Cimos/mad_lib/README.md

# mad_lib
kicad library for footprints, symbols, models, and schematics
