Cimos/mad_lib/part_library/models/MadMan/CrumbCatcherLight.step

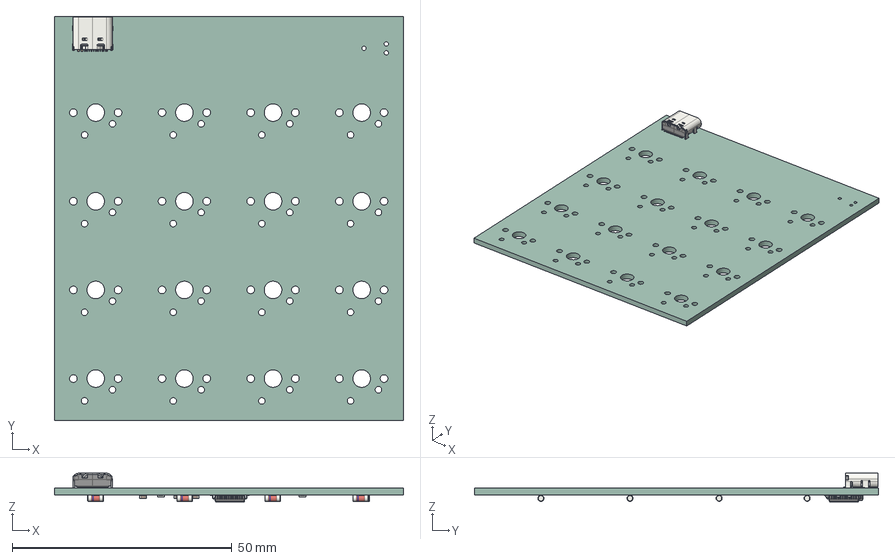
[picture p1: CAD file, 2024-03-19]
part_library/models/MadMan/CrumbCatcherLight.step
79.4 x 91.8 x 6.51 mm
USB_C_Receptacle_16P_TopMnt_Horizontal_GCT_USB4105-xx-A
R_0603_1608Metric x 6
D_MiniMELF_Standard x 16
C_0603_1608Metric x 7
LQFP_48_7x7mm_P05mm
SOT_23
CrumbCatcherLight_PCB
