Cimos/mad_lib/part_library/models/minspaced-choc-keycap.step

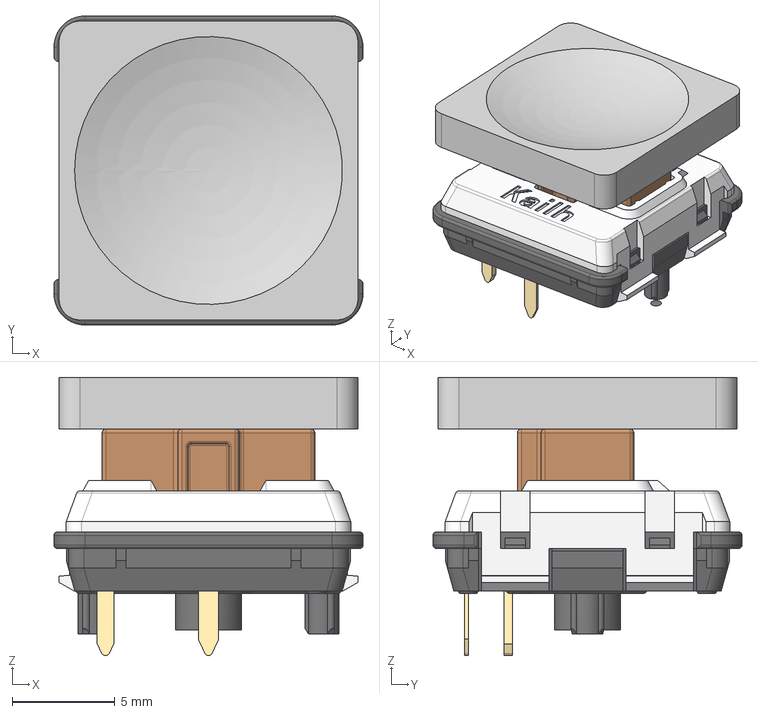
[picture p2: CAD file, 2025-12-13]
part_library/models/minspaced-choc-keycap.step
15.0 x 15.0 x 13.5 mm
