Cimos/mad_lib/part_library/models/Other/CherryMX Switch.step

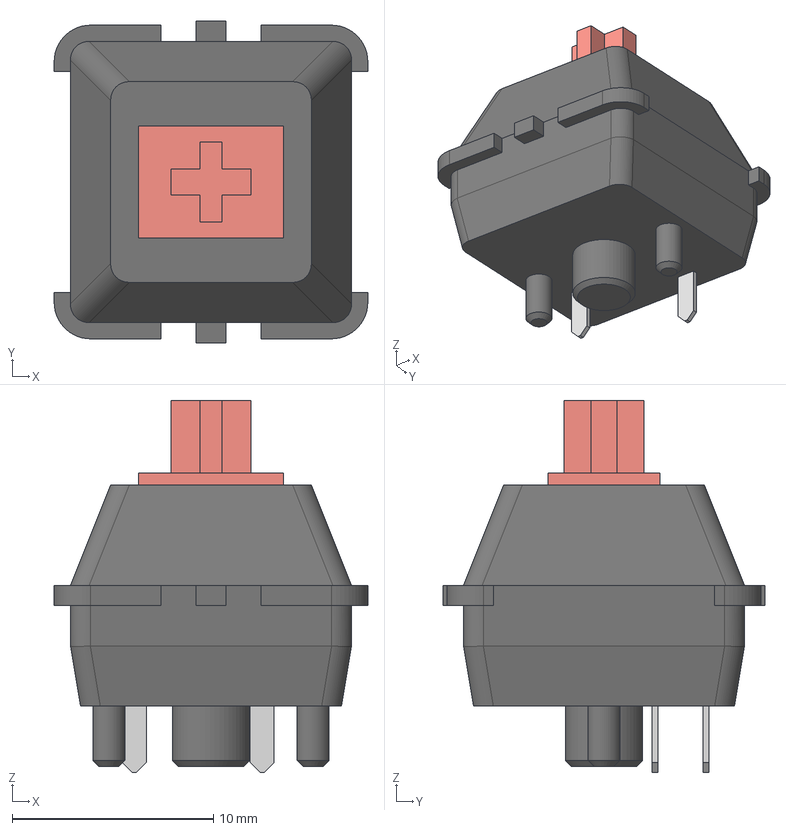
[picture p3: CAD file, 2024-03-22]
part_library/models/Other/CherryMX Switch.step
15.6 x 16.0 x 18.5 mm
