Cimos/mad_lib/mad_blocks/BQ24075RGTR.kicad_block/BQ24075RGTR.kicad_sch

## KiCad design mad_blocks/BQ24075RGTR.kicad_block/BQ24075RGTR.kicad_sch (2025-11-21)

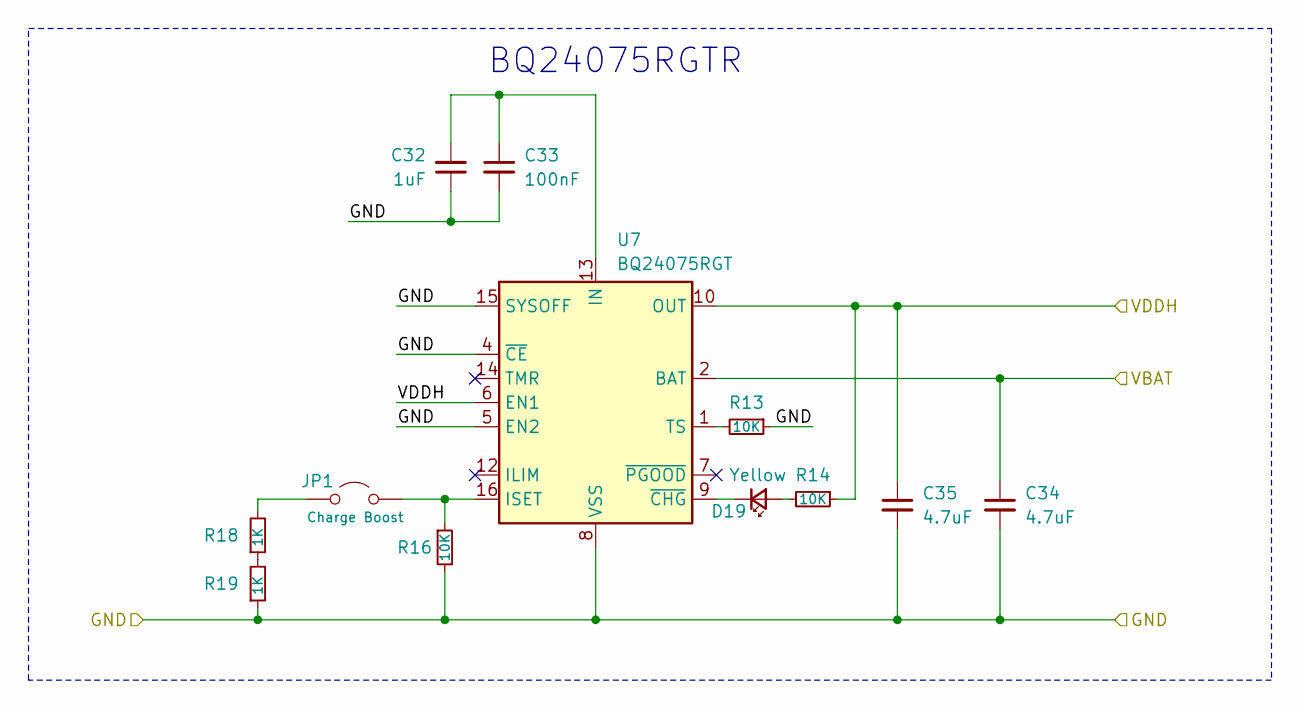
[picture p5: schematic BQ24075RGTR.kicad_sch]

Parts:
C32: 1uF; C_0603_1608Metric; Rating CAP CER 1UF 25V X5R 0603; MPN CC0603KRX5R8BB105; LCSC C14664
C33: 100nF; C_0603_1608Metric; Rating CAP CER 0.1UF 50V X7R 0603; MPN CC0603KPX7R9BB104; LCSC C432917
C34, C35: 4.7uF; C_0805_2012Metric; Rating CAP CER 4.7UF 25V X7R 0805; MPN CC0805MKX7R8BB475; digikey 311-3509-1-ND
D19: Yellow; LED_0603_1608Metric; Rating LED YELLOW CLEAR 0603 SMD; MPN 150060YS75003
JP1: Charge Boost; SolderJumper-2_P1.3mm_Open_RoundedPad1.0x1.5mm
R13, R14, R16: 10K; R_0603_1608Metric; Rating RES 10K OHM 1% 1/16W 0603; MPN RC0603FR-0710KL; LCSC C60490
R18, R19: 1K; R_0603_1608Metric; Rating RES 1K OHM 1% 1/16W 0603; MPN RC0603FR-071KL; LCSC C106235
U7: BQ24075RGT; VQFN-16-1EP_3x3mm_P0.5mm_EP1.6x1.6mm; Rating IC BATT CHG LI-ION 1CELL 16QFN; MPN BQ24075RGTR; digikey 296-38874-1-ND

Connections:
GND: C32.1, C33.2, C34.2, C35.2, R13.1, R16.2, R19.1, U7.4 (~CE), U7.5 (EN2), U7.8 (VSS), U7.15 (SYSOFF), U7.17 (VSS)
unnamed: C32.2, C33.1, U7.13 (IN)
unnamed: D19.1 (K), U7.9 (~CHG)
unnamed: D19.2 (A), R14.2
unnamed: JP1.1 (A), R16.1, U7.16 (ISET)
unnamed: JP1.2 (B), R18.2
unnamed: R13.2, U7.1 (TS)
unnamed: R18.1, R19.2
VBAT: C34.1, U7.2 (BAT), U7.3 (BAT)
VDDH: C35.1, R14.1, U7.6 (EN1), U7.10 (OUT), U7.11 (OUT)

Notes on the sheet:
BQ24075RGTR
