Cimos/mad_lib/mad_blocks/Project Basics.kicad_block/Project Basics.kicad_sch

## KiCad design mad_blocks/Project Basics.kicad_block/Project Basics.kicad_sch (2025-11-15)

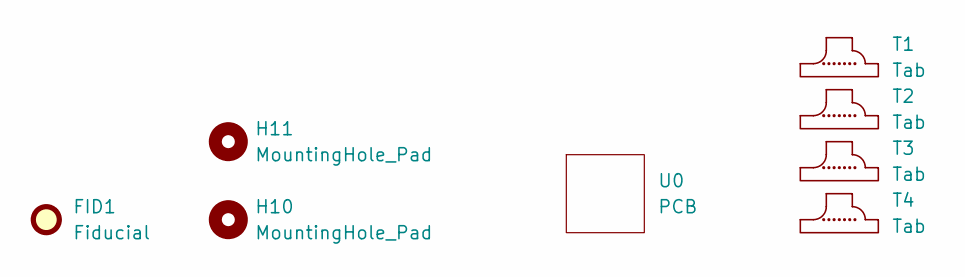
[picture p6: schematic Project Basics.kicad_sch]

Parts:
FID1: Fiducial; Fiducial_0.75mm_Mask1.5mm
H10, H11: MountingHole_Pad; MountingHole_3.2mm_M3
T1, T2, T3, T4: Tab
U0: PCB; BOM
