Cimos/mad_lib/mad_blocks/Regulator 3V3 1A.kicad_block/Regulator 3V3 1A.kicad_sch

## KiCad design mad_blocks/Regulator 3V3 1A.kicad_block/Regulator 3V3 1A.kicad_sch (2025-11-15)

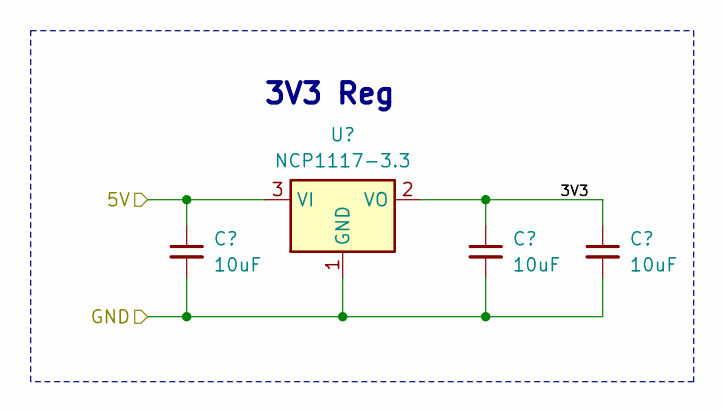
[picture p8: schematic Regulator 3V3 1A.kicad_sch]

Parts:
C4, C5, C22: 10uF; C_0805_2012Metric; Rating CAP CER 10UF 25V X5R 0805; MPN CC0805KKX5R8BB106; LCSC C2932476
U3: NCP1117-3.3; SOT-223-3_TabPin2; Rating IC REG LINEAR POS ADJ 1A SOT223; MPN NCP1117LPST33T3G; LCSC C146799

Connections:
3V3: C5.1, C22.1, U3.2 (VO)
5V: C4.1, U3.3 (VI)
GND: C4.2, C5.2, C22.2, U3.1 (GND)

Notes on the sheet:
3V3 Reg
