Cimos/mad_lib/mad_blocks/Template Keyboard Matrix.kicad_block/Template Keyboard Matrix.kicad_sch

## KiCad design mad_blocks/Template Keyboard Matrix.kicad_block/Template Keyboard Matrix.kicad_sch (2025-11-15)

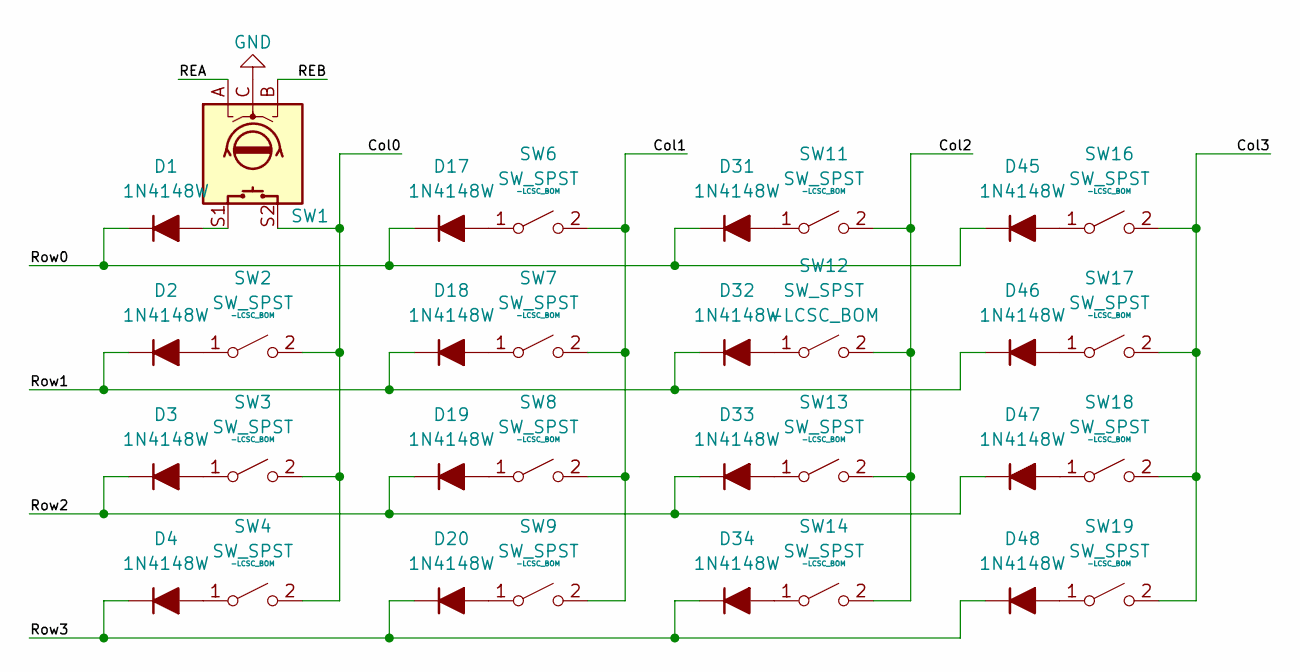
[picture p9: schematic Template Keyboard Matrix.kicad_sch]

Parts:
D1, D2, D3, D4, D17, D18, D19, D20, D31, D32, D33, D34, D45, D46, D47, D48: 1N4148W; D_SOD-123; Rating DIODE STANDARD 75V 250MA SOD123; MPN 1N4148W; LCSC C241939
SW1: RotaryEncoder_Switch; keyswitch_choc12_hotswap_1u_rotary_encoder_ec12
SW2, SW3, SW4, SW6, SW7, SW8, SW9, SW11, SW12, SW13, SW14, SW16, SW17, SW18, SW19: SW_SPST; keyswitch_choc12_hotswap_1u; Rating KAILH SW SKTS FOR MX-COMP 1=20PC; MPN CPG151101S11; LCSC C2803348

Connections:
Col0: SW1.S2, SW2.2 (B), SW3.2 (B), SW4.2 (B)
Col1: SW6.2 (B), SW7.2 (B), SW8.2 (B), SW9.2 (B)
Col2: SW11.2 (B), SW12.2 (B), SW13.2 (B), SW14.2 (B)
Col3: SW16.2 (B), SW17.2 (B), SW18.2 (B), SW19.2 (B)
GND: SW1.C
unnamed: D1.2 (A), SW1.S1
unnamed: D2.2 (A), SW2.1 (A)
unnamed: D3.2 (A), SW3.1 (A)
unnamed: D4.2 (A), SW4.1 (A)
unnamed: D17.2 (A), SW6.1 (A)
unnamed: D18.2 (A), SW7.1 (A)
unnamed: D19.2 (A), SW8.1 (A)
unnamed: D20.2 (A), SW9.1 (A)
unnamed: D31.2 (A), SW11.1 (A)
unnamed: D32.2 (A), SW12.1 (A)
unnamed: D33.2 (A), SW13.1 (A)
unnamed: D34.2 (A), SW14.1 (A)
unnamed: D45.2 (A), SW16.1 (A)
unnamed: D46.2 (A), SW17.1 (A)
unnamed: D47.2 (A), SW18.1 (A)
unnamed: D48.2 (A), SW19.1 (A)
REA: SW1.A
REB: SW1.B
Row0: D1.1 (K), D17.1 (K), D31.1 (K), D45.1 (K)
Row1: D2.1 (K), D18.1 (K), D32.1 (K), D46.1 (K)
Row2: D3.1 (K), D19.1 (K), D33.1 (K), D47.1 (K)
Row3: D4.1 (K), D20.1 (K), D34.1 (K), D48.1 (K)
