Cimos/mad_lib/mad_blocks/USB-C Interface.kicad_block/USB-C Interface.kicad_sch

## KiCad design mad_blocks/USB-C Interface.kicad_block/USB-C Interface.kicad_sch (2025-11-15)

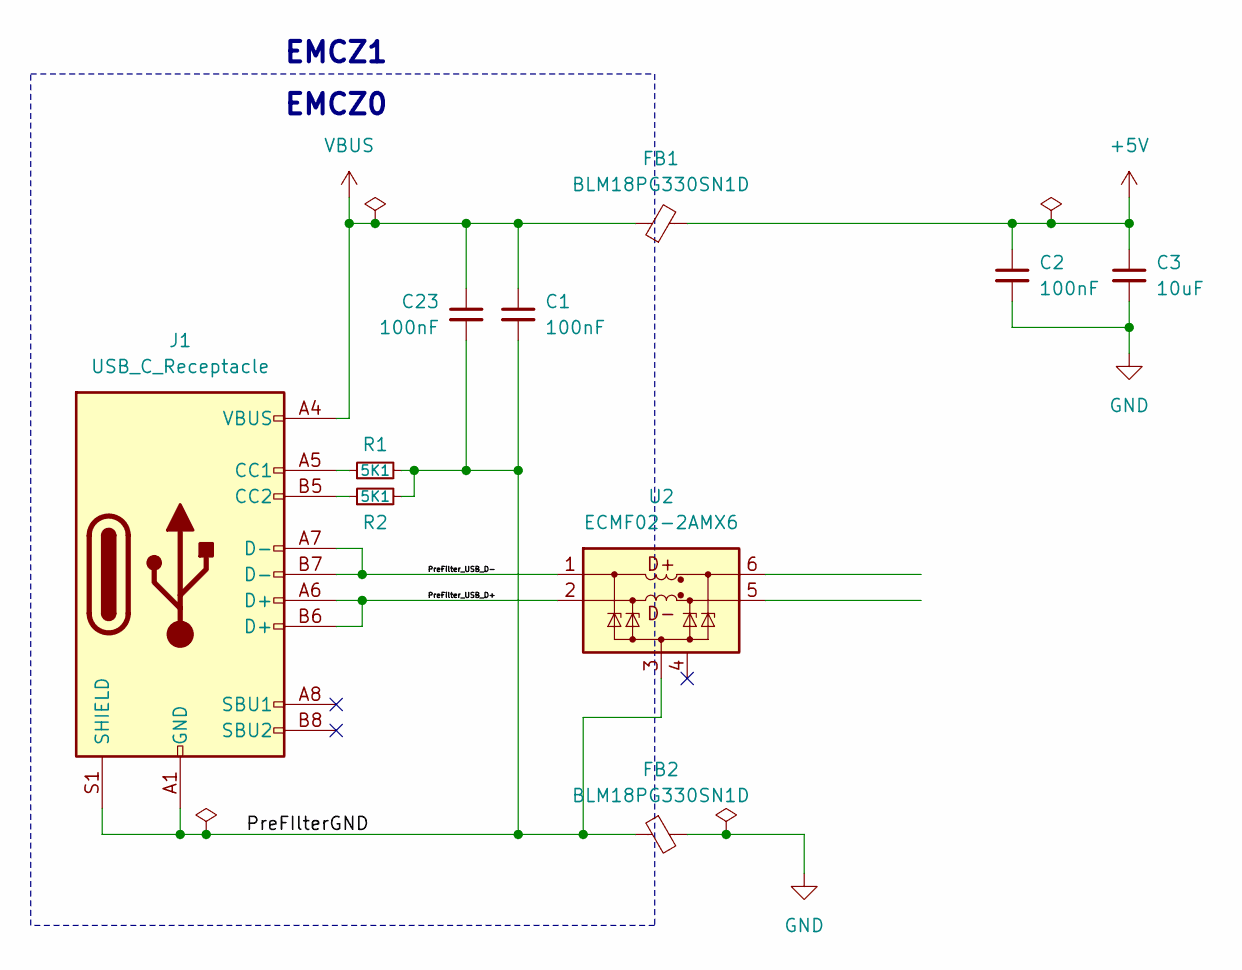
[picture p10: schematic USB-C Interface.kicad_sch]

Parts:
C1, C2, C23: 100nF; C_0603_1608Metric; Rating CAP CER 0.1UF 50V X7R 0603; MPN CC0603KPX7R9BB104; LCSC C432917
C3: 10uF; C_0805_2012Metric; Rating CAP CER 10UF 25V X5R 0805; MPN CC0805KKX5R8BB106; LCSC C2932476
FB1, FB2: BLM18PG330SN1D; L_0603_1608Metric; Rating FERRITE BEAD 33 OHM 0603 1LN; MPN BLM18PG330SN1D; LCSC C160974
J1: USB_C_Receptacle; USB_C_Receptacle_GCT_USB4105-xx-A_16P_TopMnt_Horizontal; Rating CONN RCP USB2.0 TYP C 24P SMD RA; MPN USB4105; LCSC C3020560
R1, R2: 5K1; R_0603_1608Metric; Rating RES 5.1K OHM 1% 1/10W 0603; MPN RC0603FR-075K1L; LCSC C105872
U2: ECMF02-2AMX6; ST_UQFN-6L_1.5x1.7mm_P0.5mm; Rating CMC 200MA 2LN SMD ESD; MPN ECMF02-2AMX6; LCSC C2651144

Connections:
+5V: C2.1, C3.1, FB1.2
GND: C2.2, C3.2, FB2.2
unnamed: J1.A5 (CC1), R1.1
unnamed: J1.B5 (CC2), R2.1
PreFIlterGND: C1.2, C23.2, FB2.1, J1.A1 (GND), J1.A12 (GND), J1.B1 (GND), J1.B12 (GND), J1.S1 (SHIELD), R1.2, R2.2, U2.3 (GND)
PreFilter_USB_D+: J1.A6 (D+), J1.B6 (D+), U2.2 (D-_in)
PreFilter_USB_D-: J1.A7 (D-), J1.B7 (D-), U2.1 (D+_in)
VBUS: C1.1, C23.1, FB1.1, J1.A4 (VBUS), J1.A9 (VBUS), J1.B4 (VBUS), J1.B9 (VBUS)

Notes on the sheet:
EMCZ1
EMCZ0
