Cimos/mad_lib/mad_blocks/nRF52840.kicad_block/nRF52840.kicad_sch

## KiCad design mad_blocks/nRF52840.kicad_block/nRF52840.kicad_sch (2025-11-22)

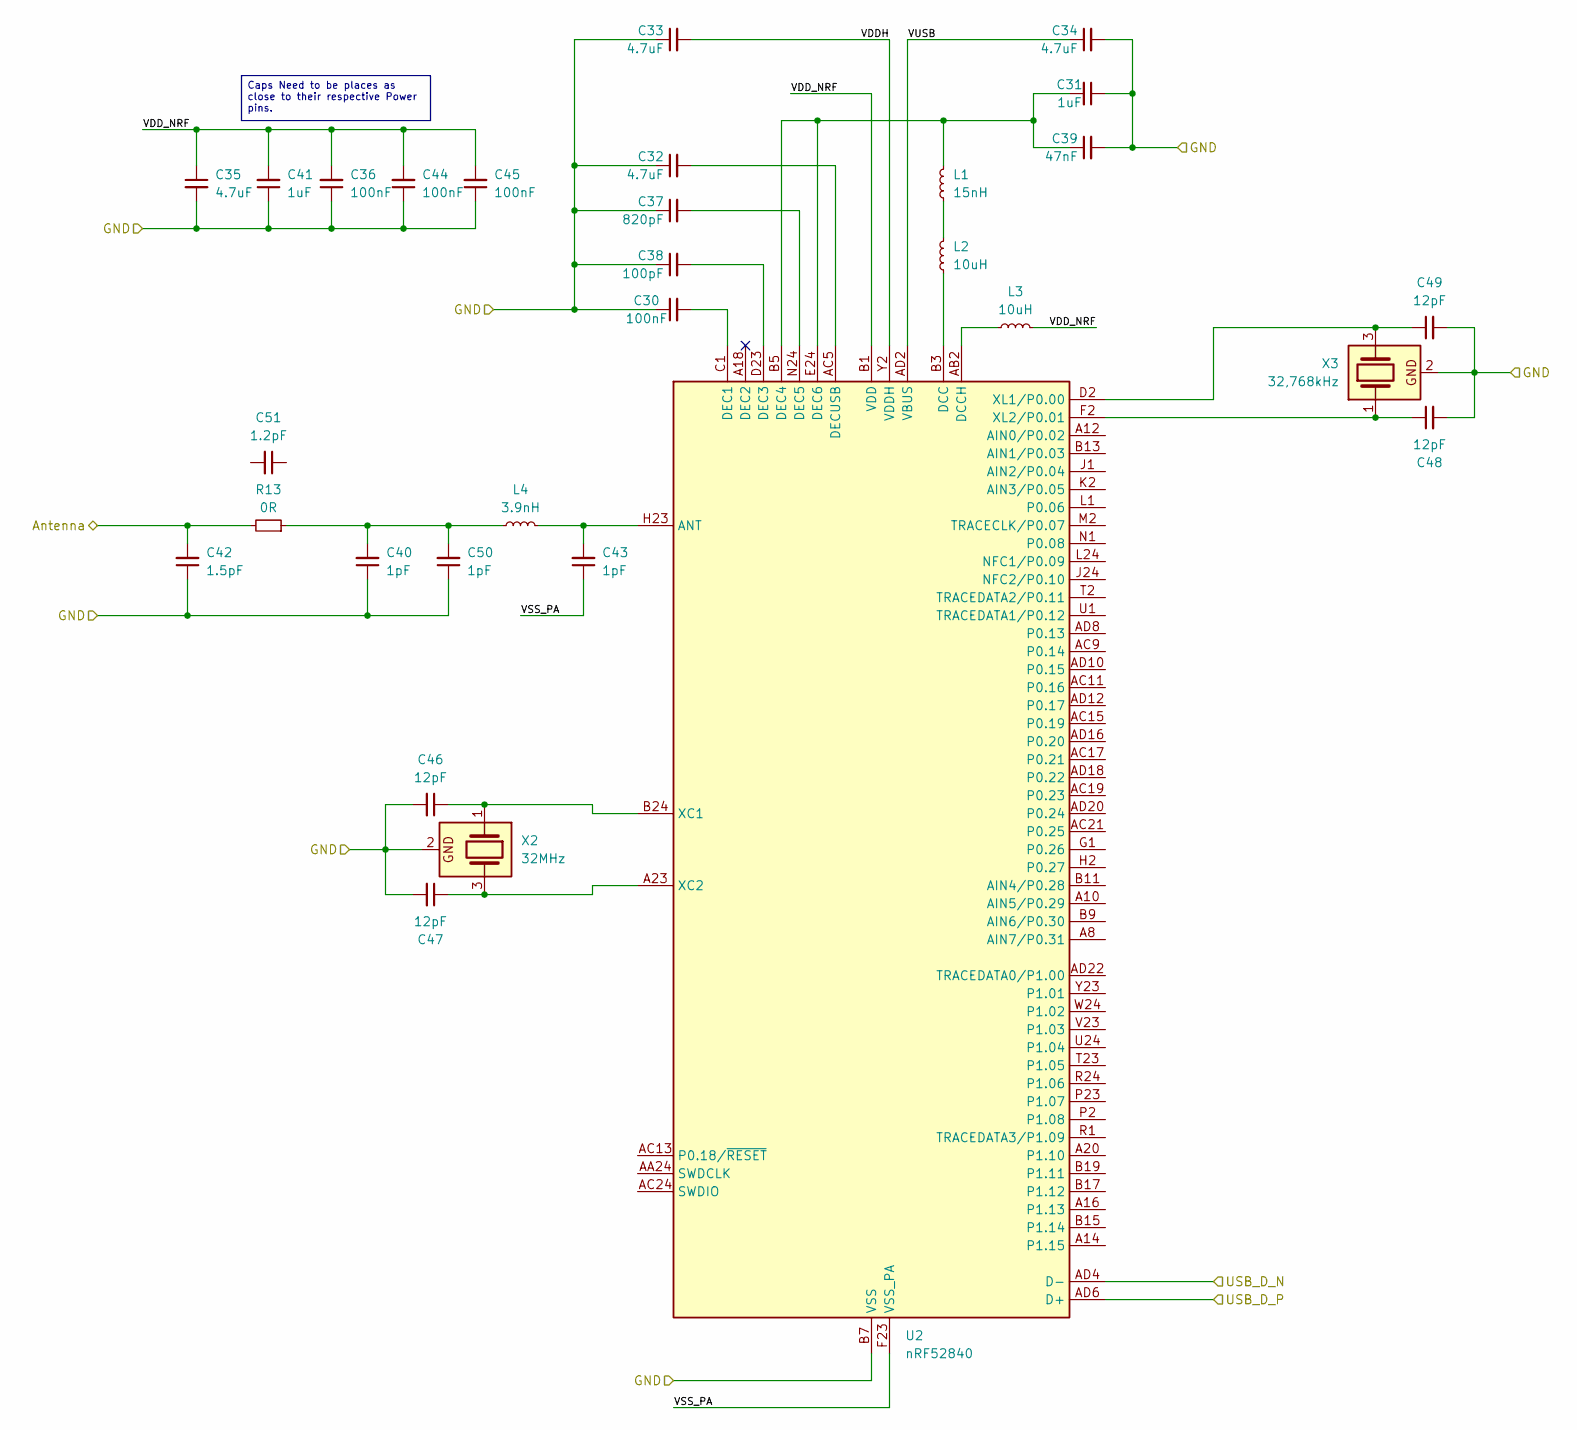
[picture p11: schematic nRF52840.kicad_sch]

Parts:
C30, C36, C44, C45: 100nF; C_0603_1608Metric; Rating CAP CER 0.1UF 50V X7R 0603; MPN CC0603KPX7R9BB104; LCSC C432917
C31, C41: 1uF; C_0603_1608Metric; Rating CAP CER 1UF 25V X5R 0603; MPN CC0603KRX5R8BB105; LCSC C14664
C32, C33, C34, C35: 4.7uF; C_0805_2012Metric; Rating CAP CER 4.7UF 25V X7R 0805; MPN CC0805MKX7R8BB475; digikey 311-3509-1-ND
C37: 820pF; C_0805_2012Metric
C38: 100pF; C_0805_2012Metric
C39: 47nF; C_0805_2012Metric
C40, C43, C50: 1pF; C_0603_1608Metric
C42: 1.5pF; C_0603_1608Metric
C46, C47, C48, C49: 12pF; C_0603_1608Metric
C51: 1.2pF; C_0603_1608Metric
L1: 15nH
L2, L3: 10uH
L4: 3.9nH
R13: 0R; R_0603_1608Metric
U2: nRF52840; Nordic_AQFN-73-1EP_7x7mm_P0.5mm
X2: 32MHz
X3: 32,768kHz

Connections:
Antenna: C42.2, R13.2
GND: C30.1, C31.1, C32.1, C33.1, C34.2, C35.2, C36.1, C37.1, C38.1, C39.2, C40.1, C41.1, C42.1, C44.1, C45.1, C46.2, C47.2, C48.2, C49.2, C50.1, U2.B7 (VSS), U2.EP (VSS), X2.2, X3.2
unnamed: C30.2, U2.C1 (DEC1)
unnamed: C31.2, C39.1, L1.2, U2.B5 (DEC4), U2.E24 (DEC6)
unnamed: C32.2, U2.AC5 (DECUSB)
unnamed: C37.2, U2.N24 (DEC5)
unnamed: C38.2, U2.D23 (DEC3)
unnamed: C40.2, C50.2, L4.1, R13.1
unnamed: C43.2, L4.2, U2.H23 (ANT)
unnamed: C46.1, U2.B24 (XC1), X2.1
unnamed: C47.1, U2.A23 (XC2), X2.3
unnamed: C48.1, U2.F2 (XL2/P0.01), X3.1
unnamed: C49.1, U2.D2 (XL1/P0.00), X3.3
unnamed: L1.1, L2.2
unnamed: L2.1, U2.B3 (DCC)
unnamed: L3.1, U2.AB2 (DCCH)
USB_D_N: U2.AD4 (D-)
USB_D_P: U2.AD6 (D+)
VDDH: C33.2, U2.Y2 (VDDH)
VDD_NRF: C35.1, C36.2, C41.2, C44.2, C45.2, L3.2, U2.A22 (VDD), U2.AD14 (VDD), U2.AD23 (VDD), U2.B1 (VDD), U2.W1 (VDD)
VSS_PA: C43.1, U2.F23 (VSS_PA)
VUSB: C34.1, U2.AD2 (VBUS)

Notes on the sheet:
Caps Need to be places as close to their respective Power pins.
