Cimos/mad_lib/mad_blocks/pmw3610.kicad_block/pmw3610.kicad_sch

## KiCad design mad_blocks/pmw3610.kicad_block/pmw3610.kicad_sch (2025-12-13)

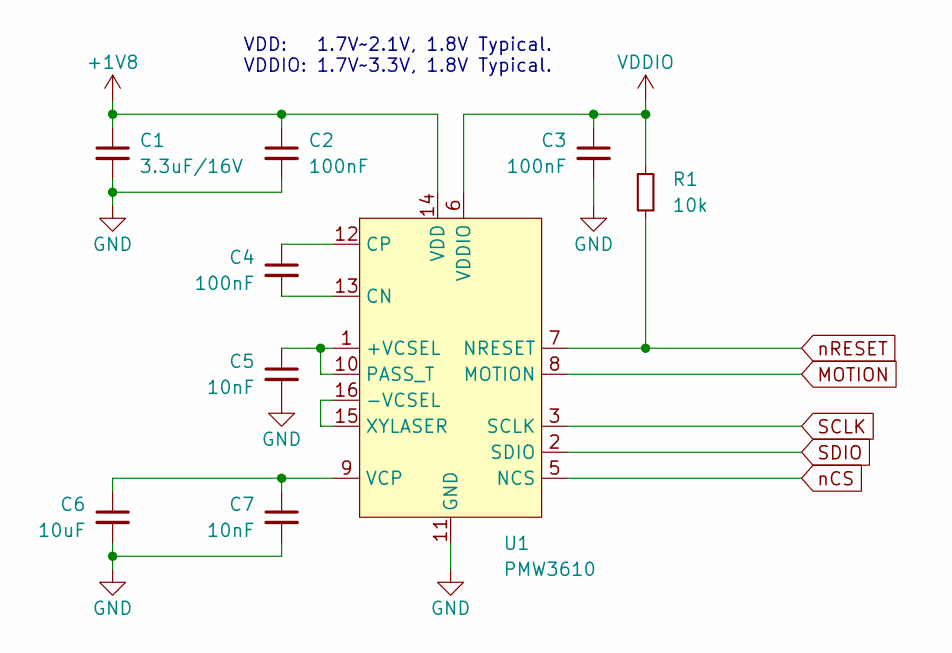
[picture p12: schematic pmw3610.kicad_sch]

Parts:
C1: 3.3uF/16V; C_0805_2012Metric; MFR. Part # TCC0805X7R335K250FT; JLCPCB Part # C7393948
C2, C3, C4: 100nF; C_0603_1608Metric; MFR. Part # CC0603KRX7R9BB104; JLCPCB Part # C14663
C5, C7: 10nF; C_0603_1608Metric; MFR. Part # 0603B103K500NT; JLCPCB Part # C57112
C6: 10uF; C_0805_2012Metric; MFR. Part # CL21A106KAYNNNE; JLCPCB Part # C15850
R1: 10k; R_0603_1608Metric; MFR. Part # 0603WAF1002T5E; JLCPCB Part # C25804
U1: PMW3610; PMW3610DM-SUDU 16Pin; MFR. Part # PMW3610DM-SUDU; JLCPCB Part # C42442560

Connections:
+1V8: C1.1, C2.1, U1.14 (VDD)
GND: C1.2, C2.2, C3.2, C5.2, C6.2, C7.2, U1.11 (GND)
MOTION: U1.8 (MOTION)
unnamed: C4.1, U1.12 (CP)
unnamed: C4.2, U1.13 (CN)
unnamed: C5.1, U1.1 (+VCSEL), U1.10 (PASS_T)
unnamed: C6.1, C7.1, U1.9 (VCP)
unnamed: U1.15 (XYLASER), U1.16 (-VCSEL)
SCLK: U1.3 (SCLK)
SDIO: U1.2 (SDIO)
VDDIO: C3.1, R1.1, U1.6 (VDDIO)
nCS: U1.5 (NCS)
nRESET: R1.2, U1.7 (NRESET)

Notes on the sheet:
VDD: 1.7V~2.1V, 1.8V Typical. VDDIO: 1.7V~3.3V, 1.8V Typical.
