Cimos/mad_lib/schematics/Keyboard Controllers/Controller_RP2040.kicad_sch

## KiCad design schematics/Keyboard Controllers/Controller_RP2040.kicad_sch (2025-11-22)

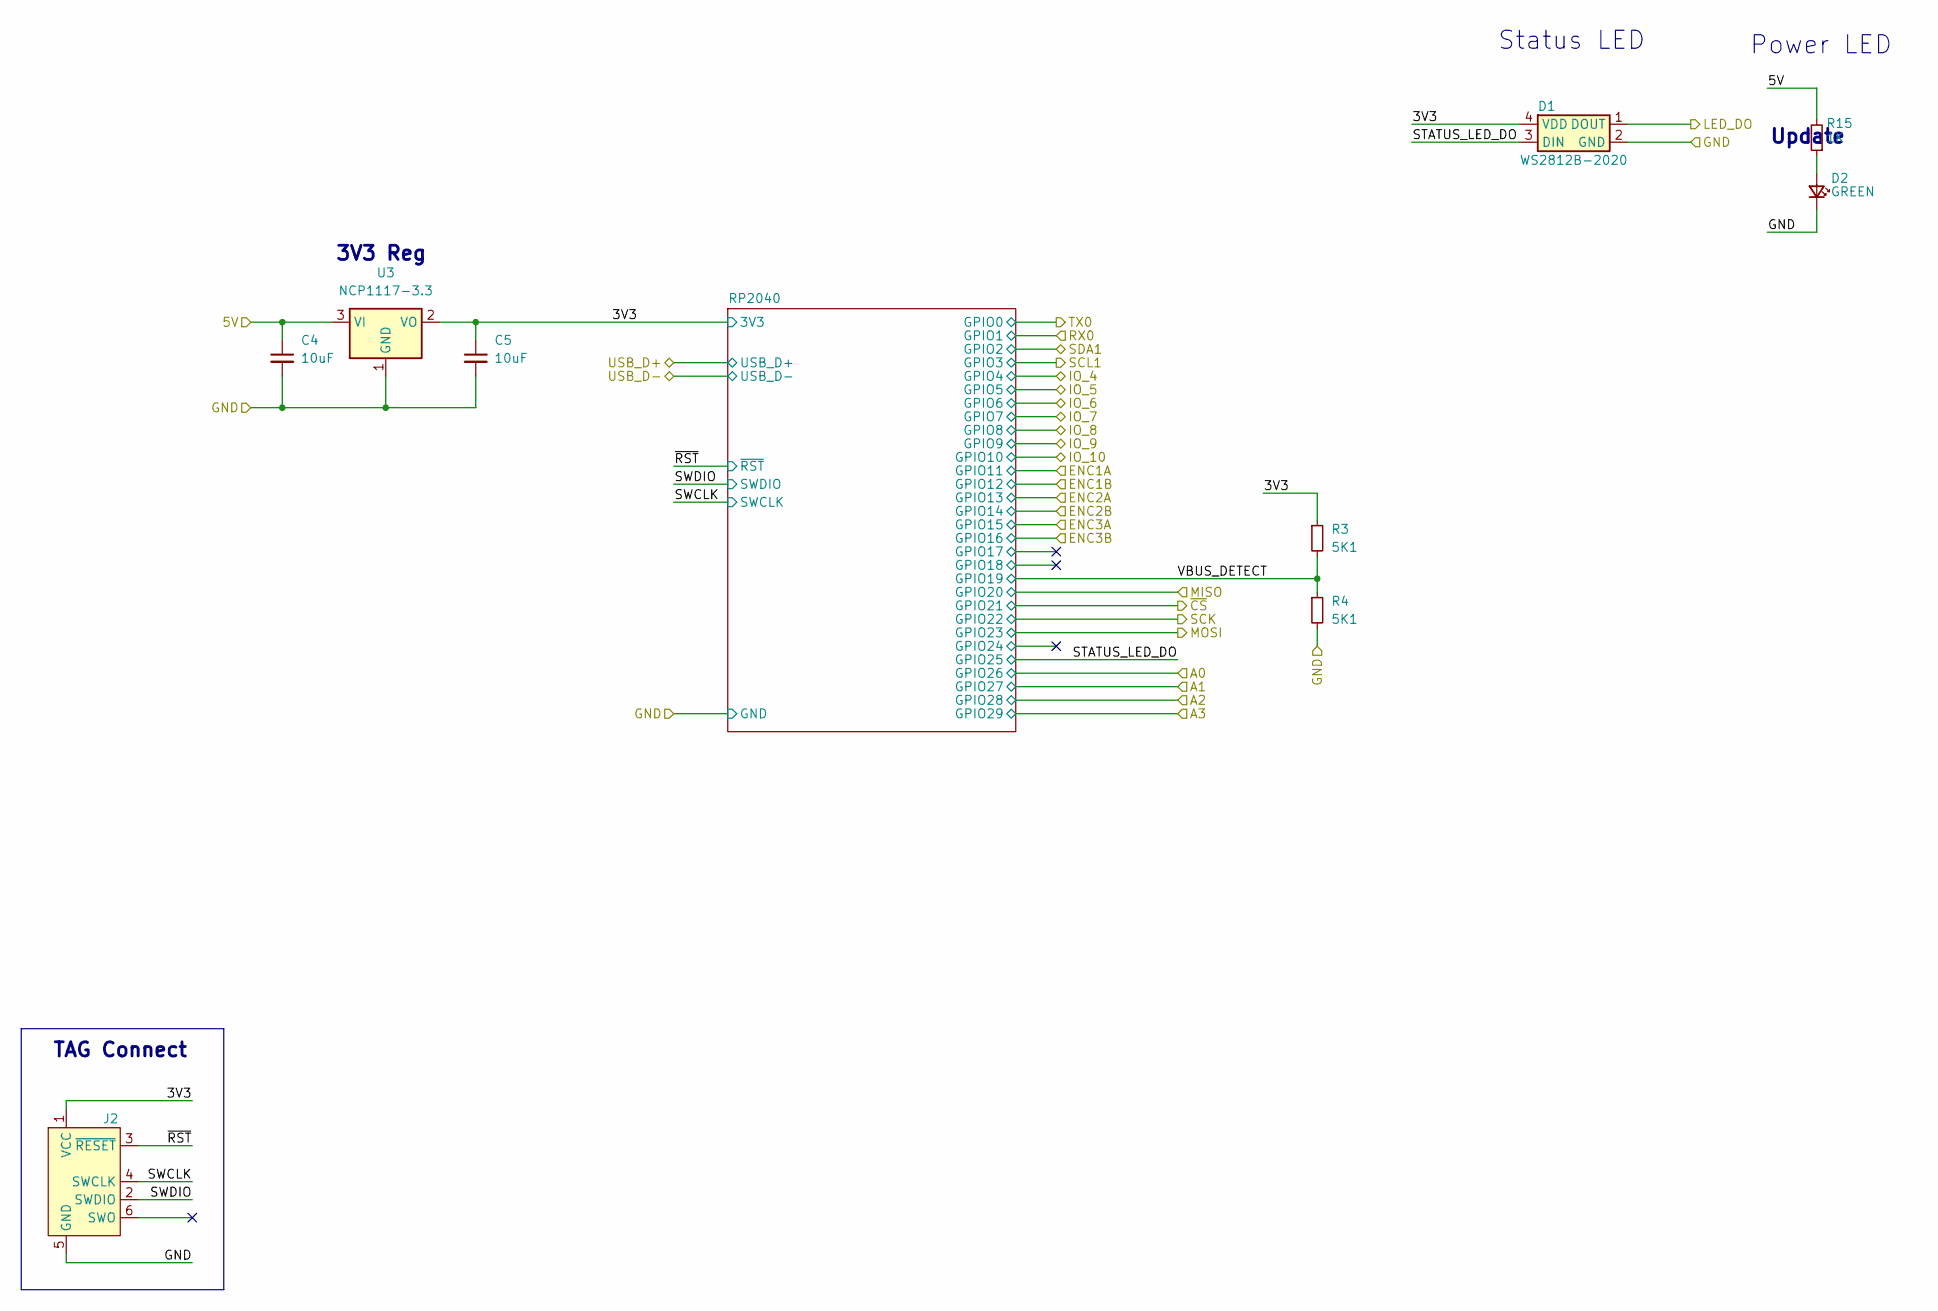
[picture p13: schematic Controller_RP2040.kicad_sch]

Parts:
C4, C5: 10uF; C_0805_2012Metric; Rating CAP CER 10UF 25V X5R 0805; MPN CC0805KKX5R8BB106; LCSC C2932476
D1: WS2812B-2020; WS2812C-2020; Rating 3.7...5.3V; MPN WS2812B-2020
D2: GREEN; LED_0603_1608Metric; Rating LED GREEN CLEAR 0603 SMD; MPN 150060VS75000
J2: Conn_ARM_SWD_TagConnect_TC2030-NL; Tag-Connect_TC2030-IDC-NL_2x03_P1.27mm_Vertical
R3, R4: 5K1; R_0402_1005Metric; Rating RES 5.1K OHM 1% 1/16W 0402; MPN RC0402FR-075K1L
R15: 1K; R_0402_1005Metric; Rating RES 1K OHM 1% 1/16W 0402; MPN RC0402FR-071KL
U3: NCP1117-3.3; SOT-223-3_TabPin2; Rating IC REG LINEAR POS ADJ 1A SOT223; MPN NCP1117LPST33T3G; LCSC C146799

Connections:
3V3: C5.1, D1.4 (VDD), J2.1 (VCC), R3.1, U3.2 (VO)
5V: C4.1, R15.2, U3.3 (VI)
GND: C4.2, C5.2, D1.2 (GND), D2.1 (K), J2.5 (GND), R4.2, U3.1 (GND)
LED_DO: D1.1 (DOUT)
unnamed: D2.2 (A), R15.1
STATUS_LED_DO: D1.3 (DIN)
SWCLK: J2.4 (SWCLK)
SWDIO: J2.2 (SWDIO)
VBUS_DETECT: R3.2, R4.1
~RST: J2.3 (~RESET)

Notes on the sheet:
Update
Power LED
Status LED
3V3 Reg
TAG Connect
