Cimos/mad_lib/schematics/MCU/MCU_RP2040.kicad_sch

## KiCad design schematics/MCU/MCU_RP2040.kicad_sch (2025-11-22)

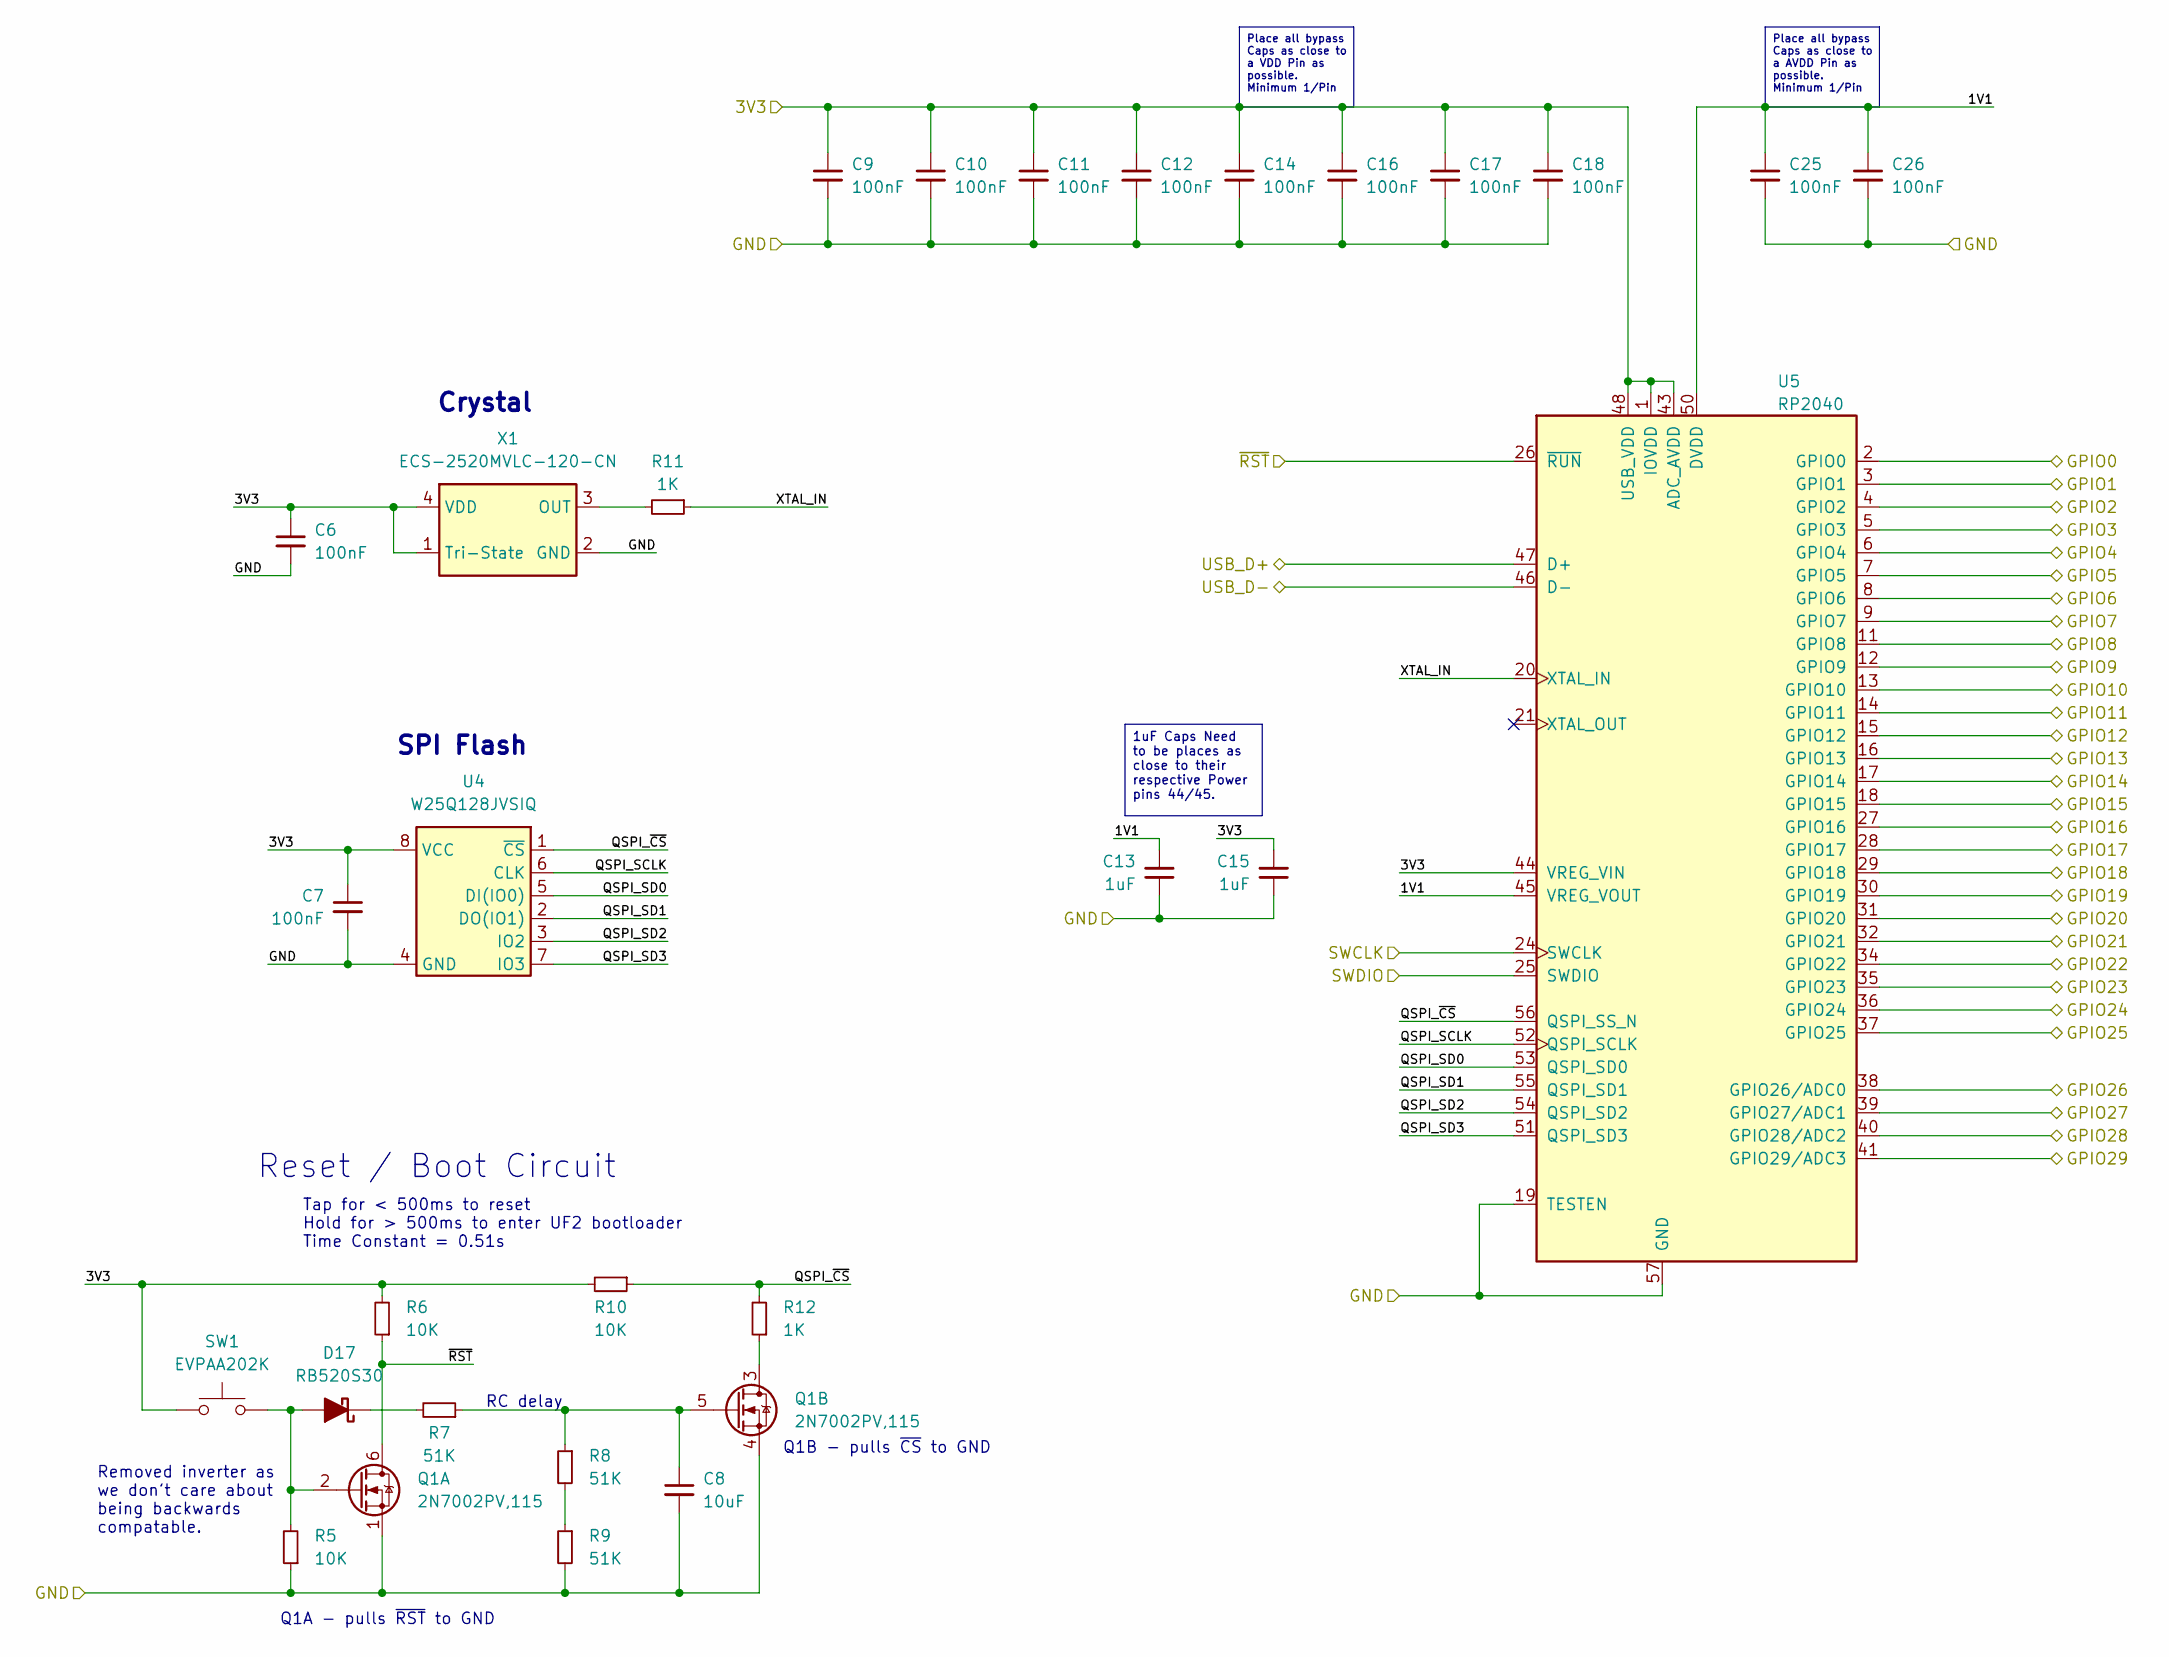
[picture p14: schematic MCU_RP2040.kicad_sch]

Parts:
C6, C7, C9, C10, C11, C12, C14, C16, C17, C18, C25, C26: 100nF; C_0603_1608Metric; Rating CAP CER 0.1UF 50V X7R 0603; MPN CC0603KPX7R9BB104; LCSC C432917
C8: 10uF; C_0805_2012Metric; Rating CAP CER 10UF 25V X5R 0805; MPN CC0805KKX5R8BB106; LCSC C2932476
C13, C15: 1uF; C_0603_1608Metric; Rating CAP CER 1UF 25V X5R 0603; MPN CC0603KRX5R8BB105; LCSC C14664
D17: RB520S30; D_SOD-523; Rating DIODE SCHOTTKY 30V 200MA SOD523; MPN RB520S30T5G; LCSC C232575
Q1: 2N7002PV,115; SOT-666; Rating MOSFET 2N-CH 60V 0.35A SOT666; MPN 2N7002PV,115; LCSC C551422
R5, R6, R10: 10K; R_0603_1608Metric; Rating RES 10K OHM 1% 1/16W 0603; MPN RC0603FR-0710KL; LCSC C60490
R7, R8, R9: 51K; R_0603_1608Metric; Rating RES 51K OHM 1% 1/16W 0603; MPN RC0603FR-0751KL; LCSC C107229
R11, R12: 1K; R_0603_1608Metric; Rating RES 1K OHM 1% 1/16W 0603; MPN RC0603FR-071KL; LCSC C106235
SW1: EVPAA202K; EVP-AA202K; Rating SWITCH TACTILE SPST-NO 0.02A 15V; MPN EVPAA202K; LCSC C79147
U4: W25Q128JVSIQ; SOIC-8_5.23x5.23mm_P1.27mm; Rating IC FLASH 128MBIT SPI/QUAD 8SOIC; MPN W25Q128JVSIQ; LCSC C97521
U5: RP2040; QFN-56-1EP_7x7mm_P0.4mm_EP3.2x3.2mm; Rating IC MCU 32BIT EXT MEM 56QFN; MPN SC0914(13); LCSC C2040
X1: ECS-2520MVLC-120-CN; Oscillator_SMD_ECS_2520MV-xxx-xx-4Pin_2.5x2.0mm; Rating XTAL OSC XO 12.0000MHZ CMOS SMD; MPN ECS-2520MVLC-120-CN-TR; LCSC C669073

Connections:
1V1: C13.2, C25.1, C26.1, U5.23 (DVDD), U5.45 (VREG_VOUT), U5.50 (DVDD)
3V3: C6.1, C7.1, C9.1, C10.1, C11.1, C12.1, C14.1, C15.2, C16.1, C17.1, C18.1, R6.2, R10.2, SW1.1, U4.8 (VCC), U5.1 (IOVDD), U5.10 (IOVDD), U5.22 (IOVDD), U5.33 (IOVDD), U5.42 (IOVDD), U5.43 (ADC_AVDD), U5.44 (VREG_VIN), U5.48 (USB_VDD), U5.49 (IOVDD), X1.1 (Tri-State), X1.4 (VDD)
GND: C6.2, C7.2, C8.2, C9.2, C10.2, C11.2, C12.2, C13.1, C14.2, C15.1, C16.2, C17.2, C18.2, C25.2, C26.2, Q1.1 (S), Q1.4 (S), R5.1, R9.2, U4.4 (GND), U5.19 (TESTEN), U5.57 (GND), X1.2 (GND)
GPIO0: U5.2 (GPIO0)
GPIO1: U5.3 (GPIO1)
GPIO2: U5.4 (GPIO2)
GPIO3: U5.5 (GPIO3)
GPIO4: U5.6 (GPIO4)
GPIO5: U5.7 (GPIO5)
GPIO6: U5.8 (GPIO6)
GPIO7: U5.9 (GPIO7)
GPIO8: U5.11 (GPIO8)
GPIO9: U5.12 (GPIO9)
GPIO10: U5.13 (GPIO10)
GPIO11: U5.14 (GPIO11)
GPIO12: U5.15 (GPIO12)
GPIO13: U5.16 (GPIO13)
GPIO14: U5.17 (GPIO14)
GPIO15: U5.18 (GPIO15)
GPIO16: U5.27 (GPIO16)
GPIO17: U5.28 (GPIO17)
GPIO18: U5.29 (GPIO18)
GPIO19: U5.30 (GPIO19)
GPIO20: U5.31 (GPIO20)
GPIO21: U5.32 (GPIO21)
GPIO22: U5.34 (GPIO22)
GPIO23: U5.35 (GPIO23)
GPIO24: U5.36 (GPIO24)
GPIO25: U5.37 (GPIO25)
GPIO26: U5.38 (GPIO26/ADC0)
GPIO27: U5.39 (GPIO27/ADC1)
GPIO28: U5.40 (GPIO28/ADC2)
GPIO29: U5.41 (GPIO29/ADC3)
unnamed: C8.1, Q1.5 (G), R7.1, R8.1
unnamed: D17.1 (K), R7.2
unnamed: D17.2 (A), Q1.2 (G), R5.2, SW1.2
unnamed: Q1.3 (D), R12.1
unnamed: R8.2, R9.1
unnamed: R11.2, X1.3 (OUT)
QSPI_SCLK: U4.6 (CLK), U5.52 (QSPI_SCLK)
QSPI_SD0: U4.5 (DI(IO0)), U5.53 (QSPI_SD0)
QSPI_SD1: U4.2 (DO(IO1)), U5.55 (QSPI_SD1)
QSPI_SD2: U4.3 (IO2), U5.54 (QSPI_SD2)
QSPI_SD3: U4.7 (IO3), U5.51 (QSPI_SD3)
QSPI_~CS: R10.1, R12.2, U4.1 (~CS), U5.56 (QSPI_SS_N)
SWCLK: U5.24 (SWCLK)
SWDIO: U5.25 (SWDIO)
USB_D+: U5.47 (D+)
USB_D-: U5.46 (D-)
XTAL_IN: R11.1, U5.20 (XTAL_IN)
~RST: Q1.6 (D), R6.1, U5.26 (~RUN)

Notes on the sheet:
SPI Flash
Tap for < 500ms to reset Hold for > 500ms to enter UF2 bootloader Time Constant = 0.51s
Removed inverter as we don't care about being backwards compatable.
Q1B - pulls ~{CS} to GND
Reset / Boot Circuit
Crystal
RC delay
Q1A - pulls ~{RST} to GND
Place all bypass Caps as close to a AVDD Pin as possible. Minimum 1/Pin
Place all bypass Caps as close to a VDD Pin as possible. Minimum 1/Pin
1uF Caps Need to be places as close to their respective Power pins 44/45.
