Cimos/mad_lib/schematics/MCU/MCU_STM32F0.kicad_sch

## KiCad design schematics/MCU/MCU_STM32F0.kicad_sch (2024-08-06)

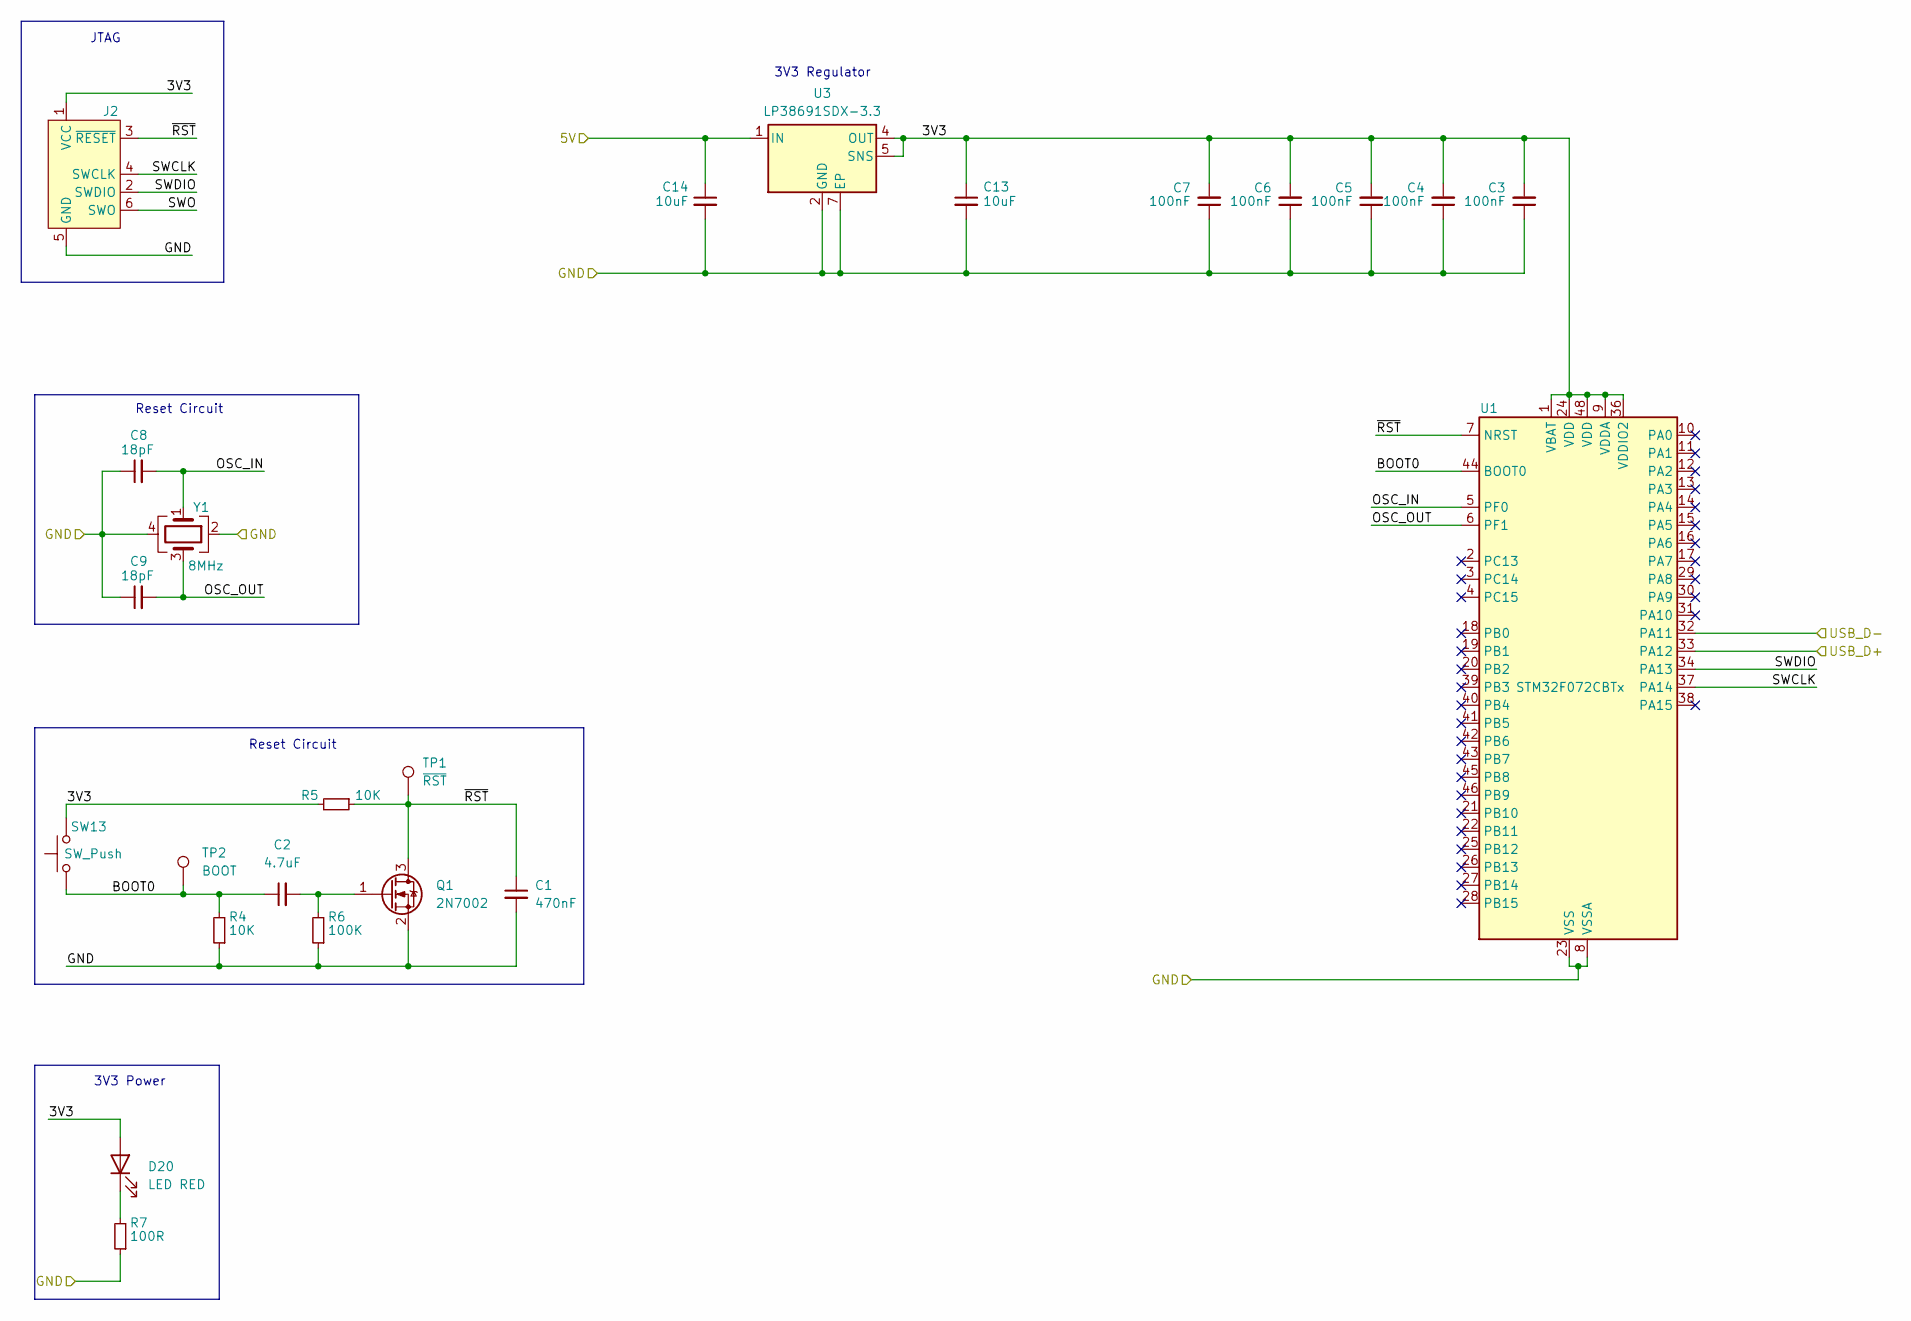
[picture p15: schematic MCU_STM32F0.kicad_sch]

Parts:
C1: 470nF; C_0603_1608Metric
C2: 4.7uF; C_0603_1608Metric
C3, C4, C5, C6, C7: 100nF; C_0402_1005Metric; Rating CAP CER 0.1UF 25V X7R 0402; MPN C0402C104K3RAC7867 KEMET $0.33 CAP CER 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
C8, C9: 18pF; C_0402_1005Metric; Rating CAP CER 18PF 50V C0G/NPO 0402; MPN CC0402FRNPO9BN180
C13, C14: 10uF; C_0805_2012Metric; Rating CAP CER 10UF 25V X5R 0805; MPN C0805C106K3PAC7800
D20: LED RED; LED_0603_1608Metric; Rating LED RED CLEAR 0603 SMD; MPN 150060RS75000
J2: Conn_ARM_SWD_TagConnect_TC2030-NL; Tag-Connect_TC2030-IDC-NL_2x03_P1.27mm_Vertical
Q1: 2N7002; SOT-23
R4, R5: 10K; R_0603_1608Metric
R6: 100K; R_0603_1608Metric
R7: 100R; R_0603_1608Metric
SW13: SW_Push
TP1: ~{RST}
TP2: BOOT
U1: STM32F072CBTx; LQFP-48_7x7mm_P0.5mm
U3: LP38691SDX-3.3; WSON-6-1EP_3x3mm_P0.95mm; Rating IC REG LINEAR 3.3V 500MA 6WSON; MPN LP38691SDX-3.3/NOPB
Y1: 8MHz; Crystal_SMD_ECX-32-4Pin_3.2x2.5mm; Rating CRYSTAL 8.0000MHZ 12PF SMD; MPN ECS-80-12-33-JGN-TR

Connections:
3V3: C3.2, C4.2, C5.2, C6.2, C7.2, C13.1, D20.2 (A), J2.1 (VCC), R5.2, SW13.1, U1.1 (VBAT), U1.9 (VDDA), U1.24 (VDD), U1.36 (VDDIO2), U1.48 (VDD), U3.4 (OUT), U3.5 (SNS)
5V: C14.1, U3.1 (IN), U3.6 (IN)
BOOT0: C2.1, R4.2, SW13.2, TP2.1, U1.44 (BOOT0)
GND: C1.2, C3.1, C4.1, C5.1, C6.1, C7.1, C8.1, C9.1, C13.2, C14.2, J2.5 (GND), Q1.2 (S), R4.1, R6.1, R7.1, U1.8 (VSSA), U1.23 (VSS), U1.35 (VSS), U1.47 (VSS), U3.2 (GND), U3.7 (EP), Y1.2, Y1.4
unnamed: C2.2, Q1.1 (G), R6.2
unnamed: D20.1 (K), R7.2
OSC_IN: C8.2, U1.5 (PF0), Y1.1
OSC_OUT: C9.2, U1.6 (PF1), Y1.3
SWCLK: J2.4 (SWCLK), U1.37 (PA14)
SWDIO: J2.2 (SWDIO), U1.34 (PA13)
SWO: J2.6 (SWO)
USB_D+: U1.33 (PA12)
USB_D-: U1.32 (PA11)
~RST: C1.1, J2.3 (~RESET), Q1.3 (D), R5.1, TP1.1, U1.7 (NRST)

Notes on the sheet:
3V3 Regulator
Reset Circuit
3V3 Power
JTAG
