Cimos/mad_lib/(commit log)

2024-03-19 Add folder structure and libraries
    [STM32F0.kicad_sch]
2024-03-19 Add crystal to lib, update stm link
    [STM32F0.kicad_sch]
2024-03-19 Add RP2040
    Taken from RP2040 guide. Thanks
    [RP2040.kicad_sch]
2024-03-19 Update title block, ignore kicad lock files
    [STM32F0.kicad_sch]
2024-03-19 Change layout to better reflect what I like
    [RP2040.kicad_sch]
2024-03-20 restructure schematics folder
    [RP2040.kicad_sch, STM32F0.kicad_sch]
2024-03-20 Add reset circuit to RP2040
    [RP2040.kicad_sch]
2024-03-22 Minor updates to STM32, refactor RP2040
    [RP2040.kicad_sch, STM32F0.kicad_sch]
2024-03-22 Fix library footprint link
    [RP2040.kicad_sch]
2024-03-22 copy used footprints into lib, link 3D models
    [CherryMX Switch.step, RP2040.kicad_sch, TL3780AF240QG.step, kailh cherry socket soldered.step, pec11r-4x15f-sxxxx.stp]
2024-03-23 Update RP2040, rename bom only footprint, add mechanical footprint
    [RP2040.kicad_sch]
2024-03-24 cleanup schematics and symbols
    [RP2040.kicad_sch]
2024-03-26 add footprint for flash and 3d model
    [GD25LQ128DYIGR.step, RP2040.kicad_sch]
2024-08-04 Minor refactor, add RP2040 controller schematic
    [RP2040.kicad_sch]
2024-08-04 Add SK6812 footprint, symbol, and step
    [LED_SK6812MINI-E.step]
2024-08-06 Add ECS footprint with model
    [SMT4_ECS-2520MVLC_ECS.step]
2024-08-06 Add WS2812 footprint and model
    [LED_WS2812_2020.step]
2024-08-06 Add SK6812 footprint
2024-08-06 Refactor RP2040, change to oscillator over crystal
    [RP2040.kicad_sch]
2024-08-06 Cleanup, BOM Update, Expose LED DOUT for internal status led
    [RP2040.kicad_sch]
2024-08-06 Fix naming confilict
    [Controller_RP2040.kicad_sch, MCU_RP2040.kicad_sch, MCU_STM32F0.kicad_sch, RP2040.kicad_sch, STM32F0.kicad_sch]
2024-08-07 add todo
    [Controller_RP2040.kicad_sch]
2024-08-08 Update schematic
    [Controller_RP2040.kicad_sch, MCU_RP2040.kicad_sch]
2024-08-08 Rename sk mini leds, update datasheets and descriptions, add new parts and steps
    [LED_SK6812MINI-012.step, QFN-6L_STM.step]
2024-08-09 Add new parts, clean up old ones
    [SOIC_128JVSIQ_WIN.step, evpaa202k.stp]
2024-08-10 point to madlib footprint
2024-08-10 Part update, point to mad lib footprint
2024-08-11 Update Pushbutton footprint, add courtyard
2024-08-11 Add rounded corners on cutout, allow .3mm gap for pad to cutout
2024-08-15 Move steps to folders
    [CrumbCatcherLight.step, LED_WS2812_2020.step]
2025-04-05 Update pin out for sk6812Mini
2025-05-01 Add 3 Pin GH
    [SM03B-GHS-TB.STEP]
2025-05-03 Remove local GH footprint, use KiCAD GH footprint.
    [SM03B-GHS-TB.STEP]
2025-11-15 Add design blocks
    [Project Basics.kicad_sch, RP2040.kicad_sch, Regulator 3V3 1A.kicad_sch, Template Keybaord Matrix.kicad_sch, USB-C Interface.kicad_sch]
2025-11-21 Cleanup design blocks, add bq240xx
    [BQ24075RGTR.kicad_sch, Controller_RP2040.kicad_sch, MCU_RP2040.kicad_sch, Template Keyboard Matrix.kicad_sch]
2025-11-22 Add common design blocks
    [Tag Connect.kicad_sch, nRF52840.kicad_sch]
2025-11-22 Update lib, embed models into footprints and remove from models folder
    [Controller_RP2040.kicad_sch, GD25LQ128DYIGR.step, LED_SK6812MINI-012.step, LED_SK6812MINI-E.step, LED_WS2812_2020.step, MCU_RP2040.kicad_sch, QFN-6L_STM.step, SMT4_ECS-2520MVLC_ECS.step]
2025-11-26 Add 32KHz footprint
2025-11-30 Adds SOD-123 diode footprint
    Adds a new footprint for the SOD-123 diode package.
    This footprint provides an alternative option to existing
    KiCad libraries, potentially improving design flexibility
    and component sourcing.
2025-12-13 Add minspaced choc keycap
    [minspaced-choc-keycap.step]
2025-12-13 Adds PMW3610 optical mouse sensor block
    Adds schematic and JSON files for the PMW3610 optical mouse sensor.
    This introduces a new block that can be used in KiCad
    projects for interfacing with the PMW3610 sensor, including
    necessary passive components and power supply connections.
    [pmw3610.kicad_sch]
